ZJUZZH/Deformation-Capture-By-IMU-Sensor-Network/Arduino_program/Arduino_V2/README.txt

修改了I2C通信中传感器数据的格式，提升了数据传输效率

The format of sensor data in I2C communication is modified to improve data transmission efficiency
