ZJUZZH/Deformation-Capture-By-IMU-Sensor-Network/PCB/Slave/2023(MPU6050)/README.txt

EDA software version: standard version

https://lceda.cn/editor

It is recommended to replace the 8Mhz active crystal oscillator in the PCB with a 16Mhz or 20Mhz passive crystal oscillator
