ZJUZZH/Deformation-Capture-By-IMU-Sensor-Network/PCB/Master/V3/README.txt

Arduino version: Seeed Studio XIAO nRF52840 Sense
