ZJUZZH/Deformation-Capture-By-IMU-Sensor-Network/Arduino_program/Arduino_V2/Slave/README.txt

The arduino board library:  https://github.com/MCUdude/MiniCore.git
