ZJUZZH/Deformation-Capture-By-IMU-Sensor-Network/PCB/Master/V2/README.txt

Arduino version: Arduino nano 33 ble sense
