ZJUZZH/Deformation-Capture-By-IMU-Sensor-Network/Arduino_program/1-Calibration_mpu6050toEEPROM/README.txt

1. Load this program into the slave sensor node.
2. Collect the calibration parameters of IMU sensor. The parameters will be saved in the EEPROM of the chip Atmega328P automatically.
3. Then reload the [3-slave] program into the slave sensor node.
