ZJUZZH/Deformation-Capture-By-IMU-Sensor-Network/(list of files, drawings)

Other design files:
PCB/Master/V2/PCB_PCB_MasterNode_V2_2024-03-10.json
PCB/Master/V2/SCH_MasterNode_V2_2024-03-10.json
PCB/Master/V3/PCB_PCB_MasterNodeV3_2024-03-10.json
PCB/Master/V3/SCH_MasterNodeV3_2024-03-10.json
PCB/Slave/2023(MPU6050)/PCB_PCB_4connectors_antiCW_4layers new0421.json
PCB/Slave/2023(MPU6050)/PCB_PCB_4connectors_array.json
PCB/Slave/2023(MPU6050)/PCB_PCB_4connectors_CW_4layers new0421.json
PCB/Slave/2023(MPU6050)/PCB_PCB_array_with_number.json
PCB/Slave/2023(MPU6050)/SCH_IMU_4connectors_antiCW.json
PCB/Slave/2023(MPU6050)/SCH_IMU_4connectors_CW.json
